msabry490/Embedded-Project/Model/M1-2.jpg

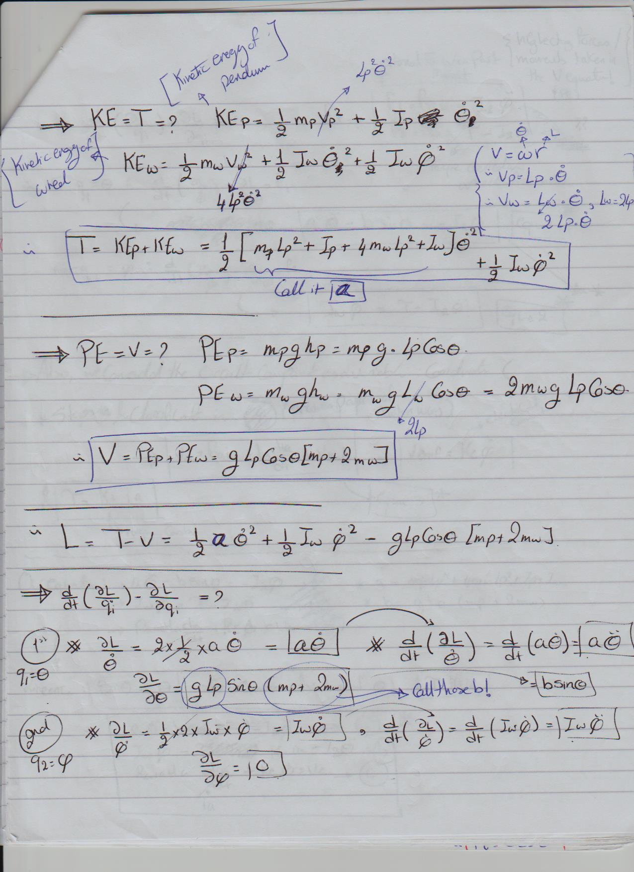
Model/M1-2.jpg
