msabry490/Embedded-Project/Model/M1-5.jpg

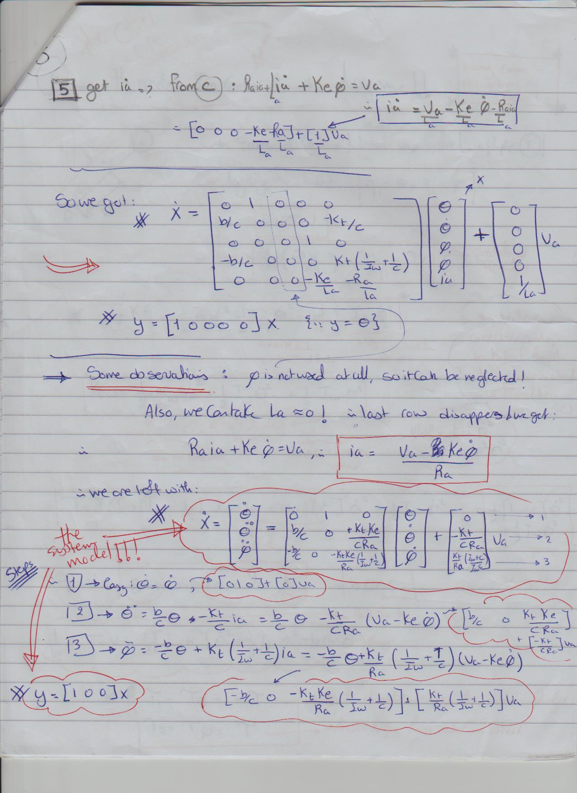
Model/M1-5.jpg
