msabry490/Embedded-Project/Model/M1-1.jpg

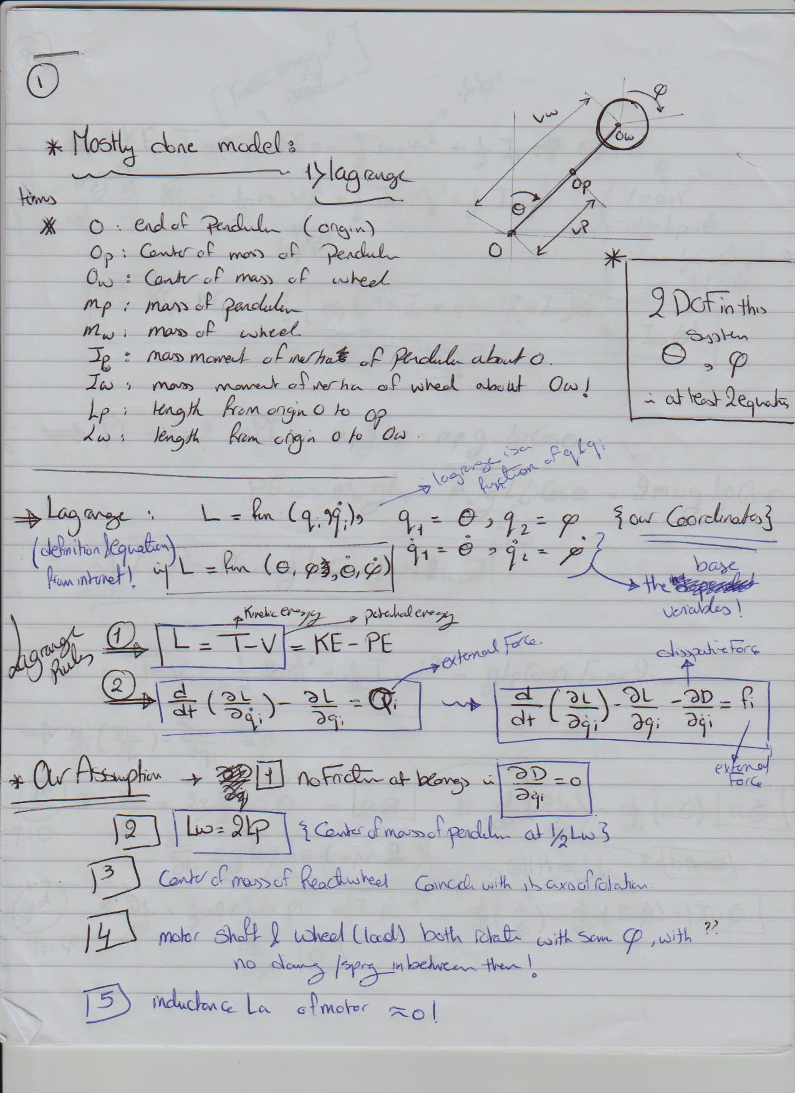
Model/M1-1.jpg
