msabry490/Embedded-Project/Model/M1-3.jpg

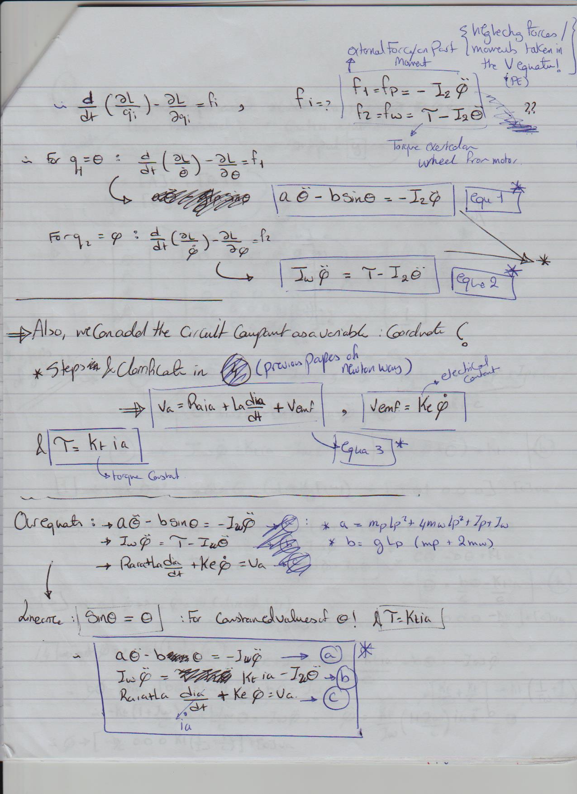
Model/M1-3.jpg
