msabry490/Embedded-Project/Model/M1-4.jpg

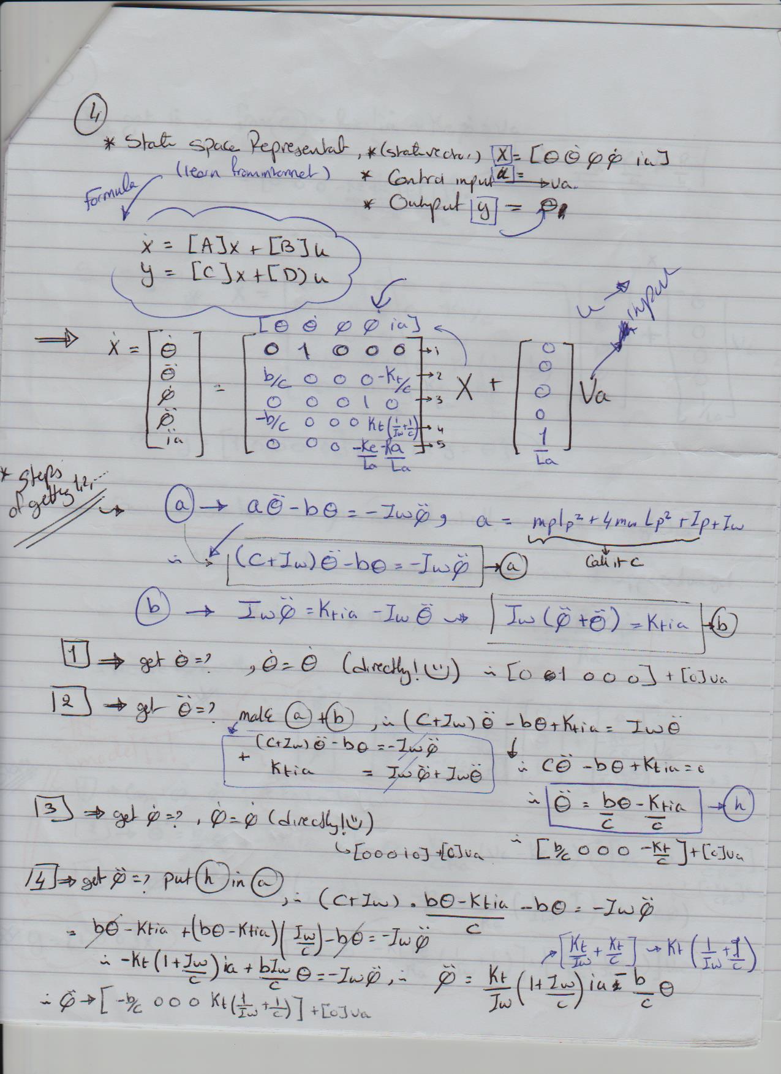
Model/M1-4.jpg
