msabry490/Embedded-Project/Simulation/Sim.png

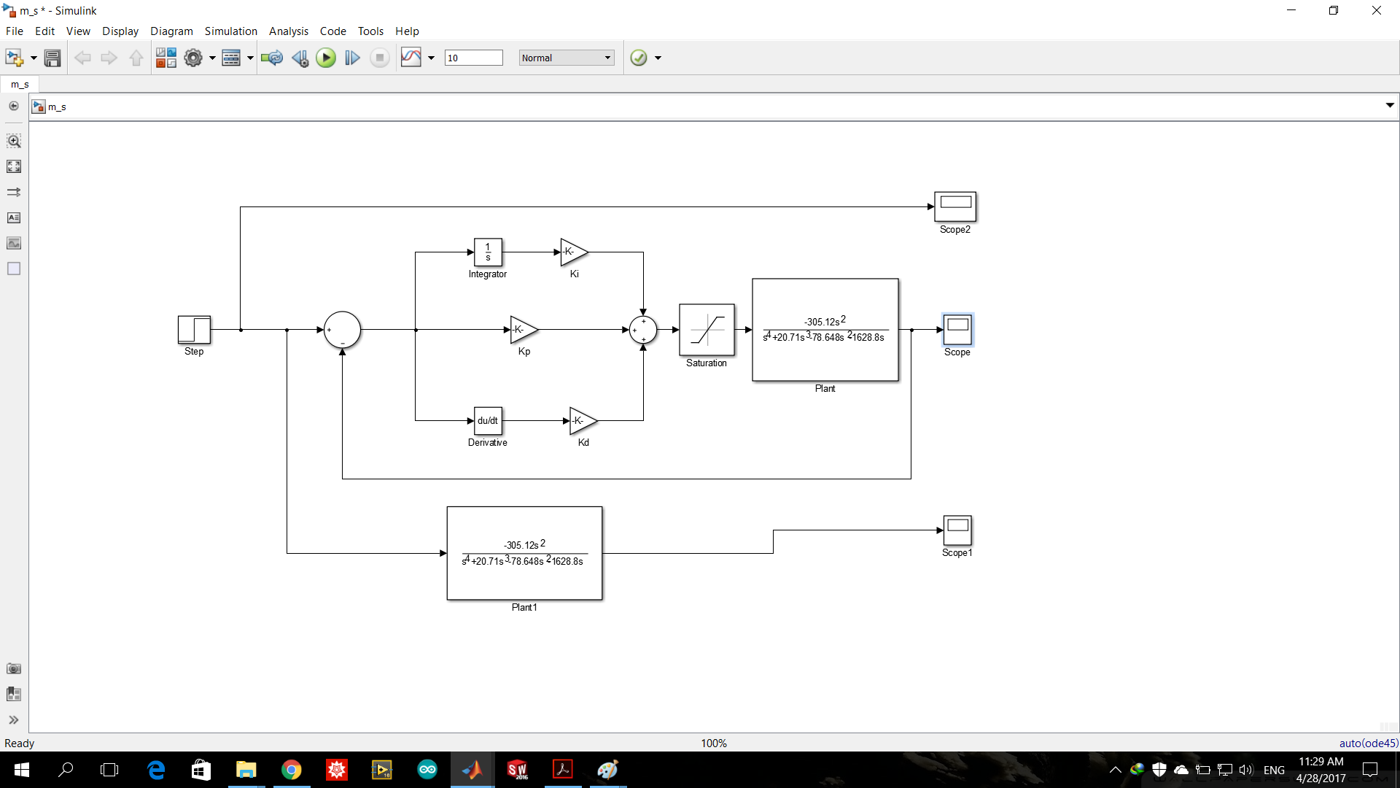
Simulation/Sim.png
