msabry490/Embedded-Project/Solid Part/final.SLDASM

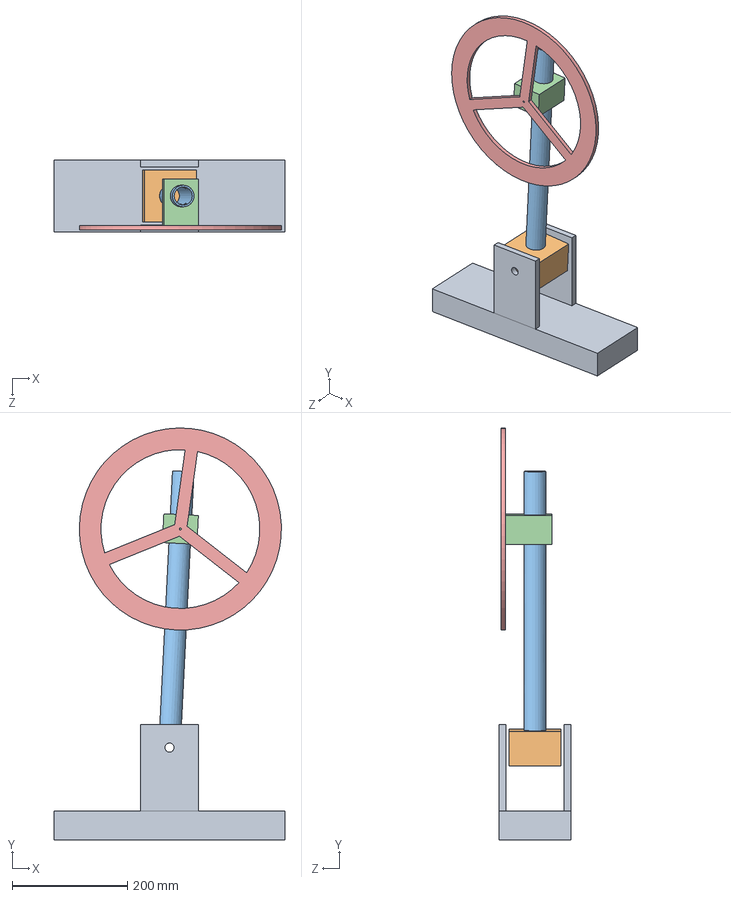
[picture p26: CAD file, 2019-09-03]
Solid Part/final.SLDASM
400.0 x 713.5 x 125.0 mm
wooden-base
first
mod1
wheel
