msabry490/Embedded-Project/Solid Part/test assembly.SLDASM

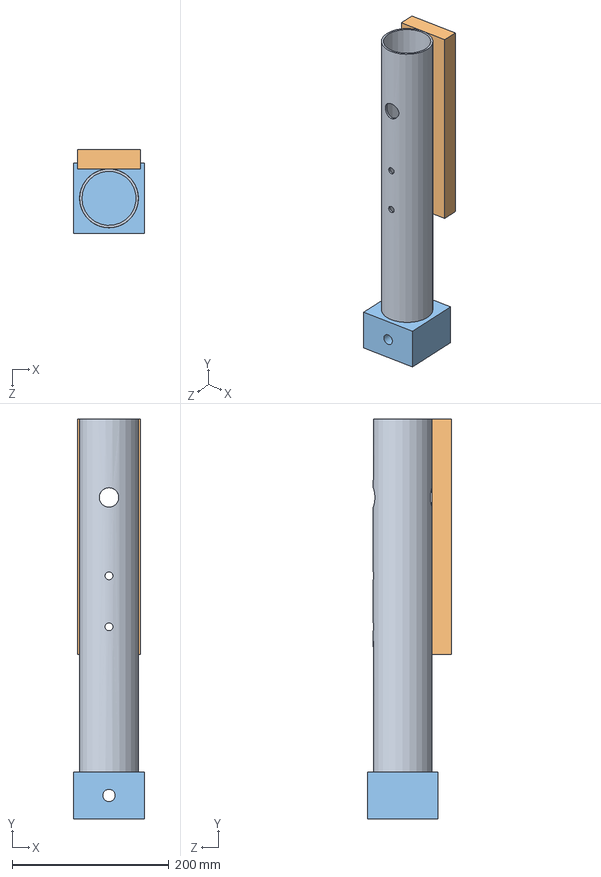
[picture p27: CAD file, 2019-09-03]
Solid Part/test assembly.SLDASM
90.0 x 510.0 x 107.5 mm
second
first
