msabry490/Embedded-Project/Solid Part/inertia model.SLDASM

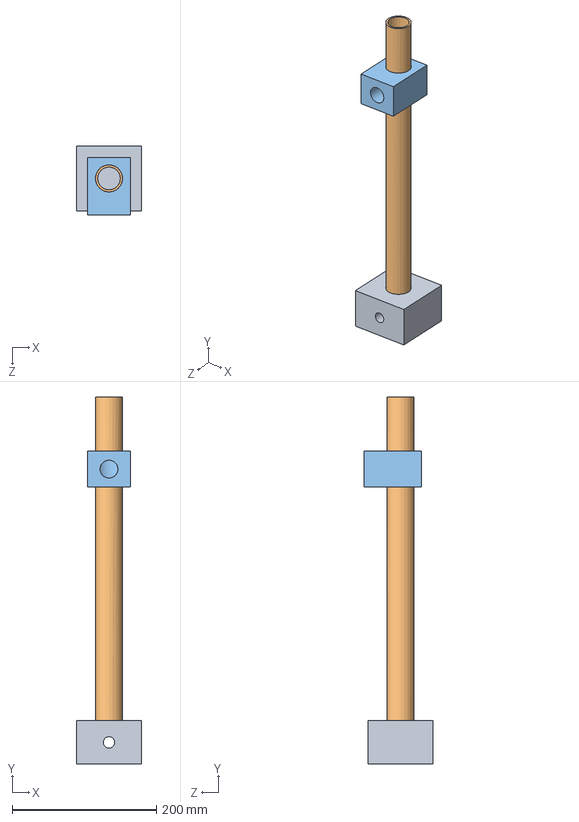
[picture p28: CAD file, 2019-09-03]
Solid Part/inertia model.SLDASM
90.0 x 509.0 x 95.8 mm
first
mod1
