msabry490/Embedded-Project/Solid Part/wheel.SLDPRT

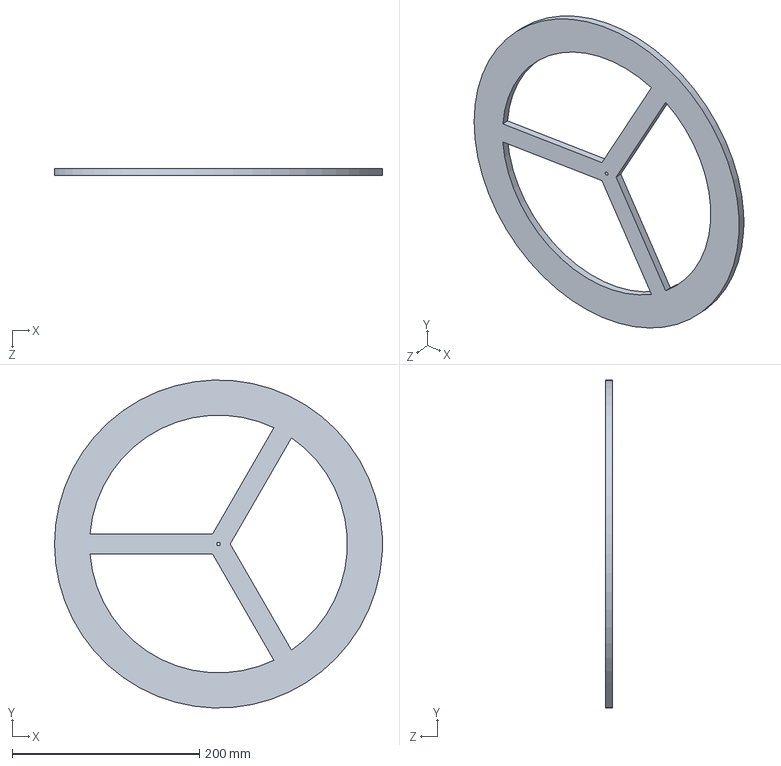
[picture p29: CAD file, 2019-09-03]
Solid Part/wheel.SLDPRT
350.0 x 349.8 x 8.00 mm
