msabry490/Embedded-Project/Solid Part/reaction wheel.SLDPRT

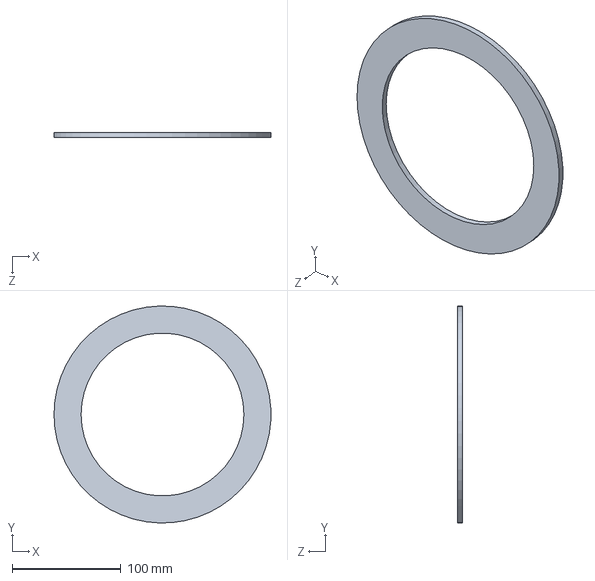
[picture p30: CAD file, 2019-09-03]
Solid Part/reaction wheel.SLDPRT
200.0 x 199.9 x 5.00 mm
