msabry490/Embedded-Project/Solid Part/wooden-base.SLDPRT

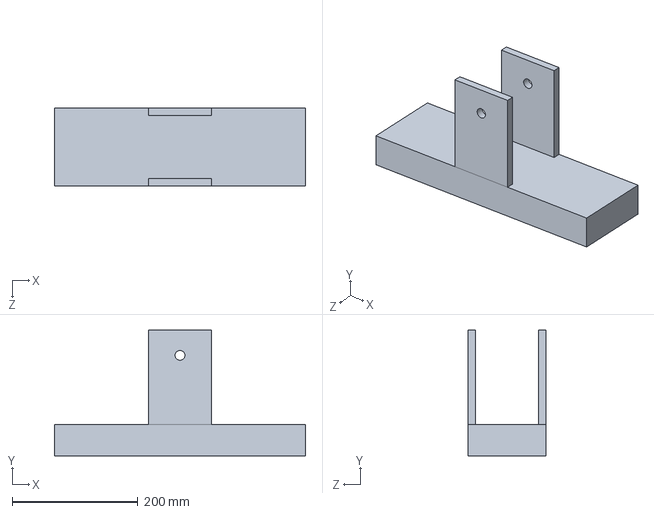
[picture p31: CAD file, 2019-09-03]
Solid Part/wooden-base.SLDPRT
400.0 x 200.0 x 125.0 mm
