msabry490/Embedded-Project/Solid Part/cylinder(1).SLDPRT

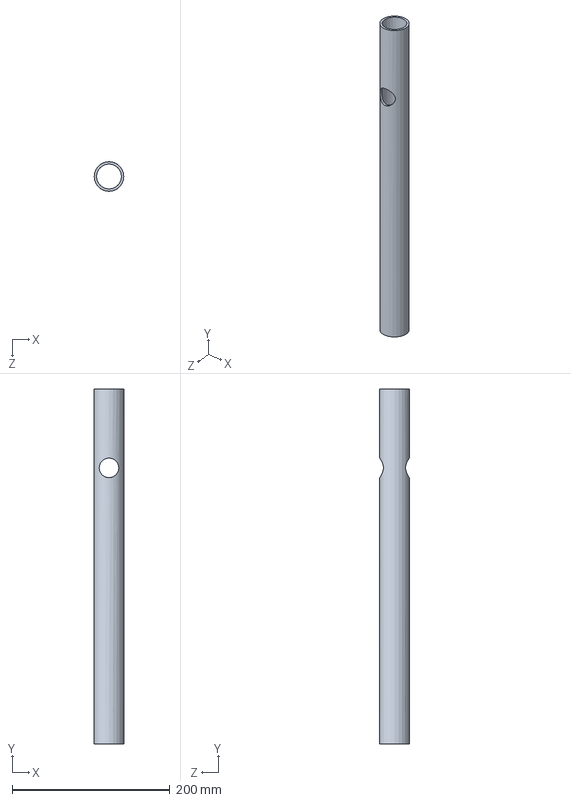
[picture p32: CAD file, 2019-09-03]
Solid Part/cylinder(1).SLDPRT
37.5 x 450.0 x 37.5 mm
