msabry490/Embedded-Project/Solid Part/inertiabar.SLDPRT

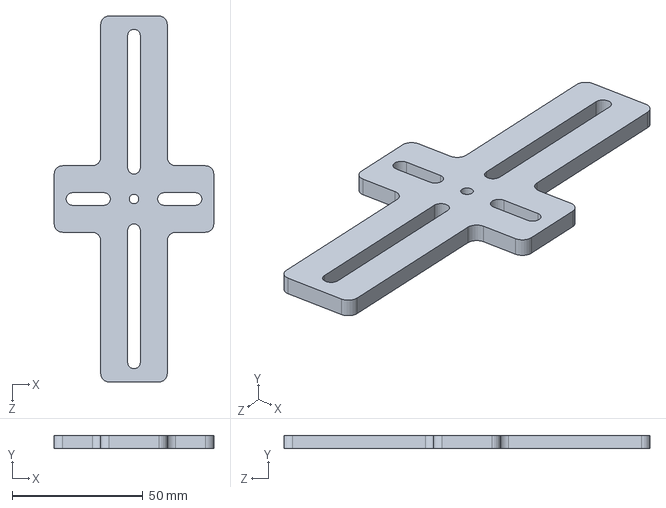
[picture p33: CAD file, 2019-09-03]
Solid Part/inertiabar.SLDPRT
61.0 x 5.08 x 139.7 mm
