msabry490/Embedded-Project/Solid Part/mod1.SLDPRT

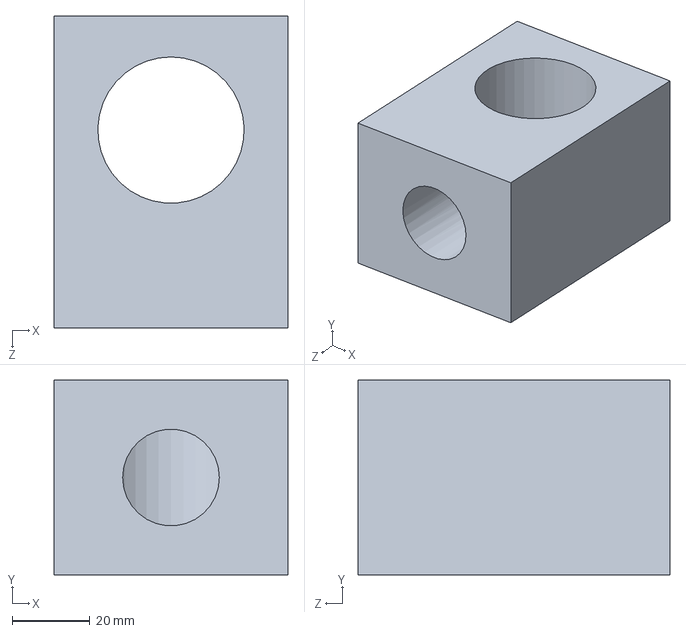
[picture p34: CAD file, 2019-09-03]
Solid Part/mod1.SLDPRT
60.0 x 50.0 x 80.0 mm
