msabry490/Embedded-Project/Solid Part/second.SLDPRT

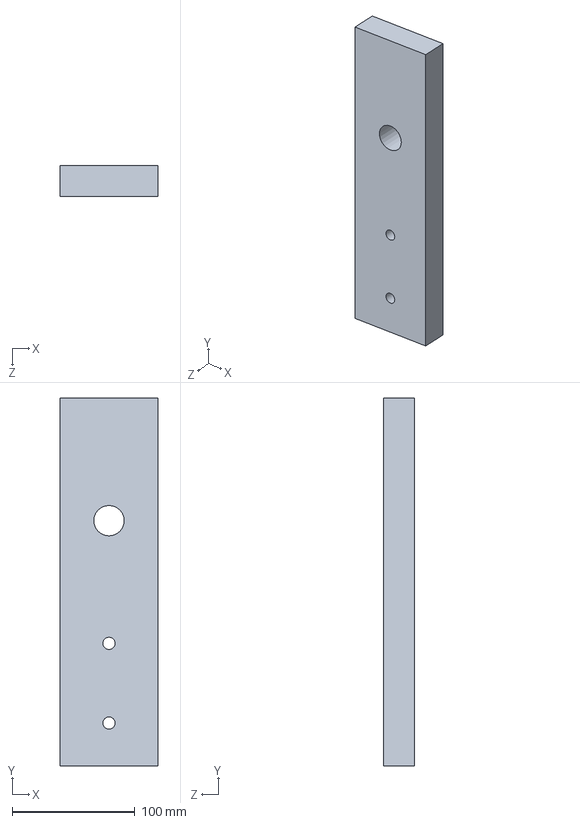
[picture p35: CAD file, 2019-09-03]
Solid Part/second.SLDPRT
80.0 x 300.0 x 25.0 mm
